Elmue/RFID-Secure-Doorlock/README.md

# RFID-Secure-Doorlock
An electronic doorlock that replaces an unsafe mechanical key with a RFID card using strong encryption.

Before you used:

Key

Now you use:

Mifare

For a detailed description please see:
https://netcult.ch/elmue/RFID-Secure-Doorlock/
