Elmue/RFID-Secure-Doorlock/DataSheets/Mifare Card Detection Procedure.png

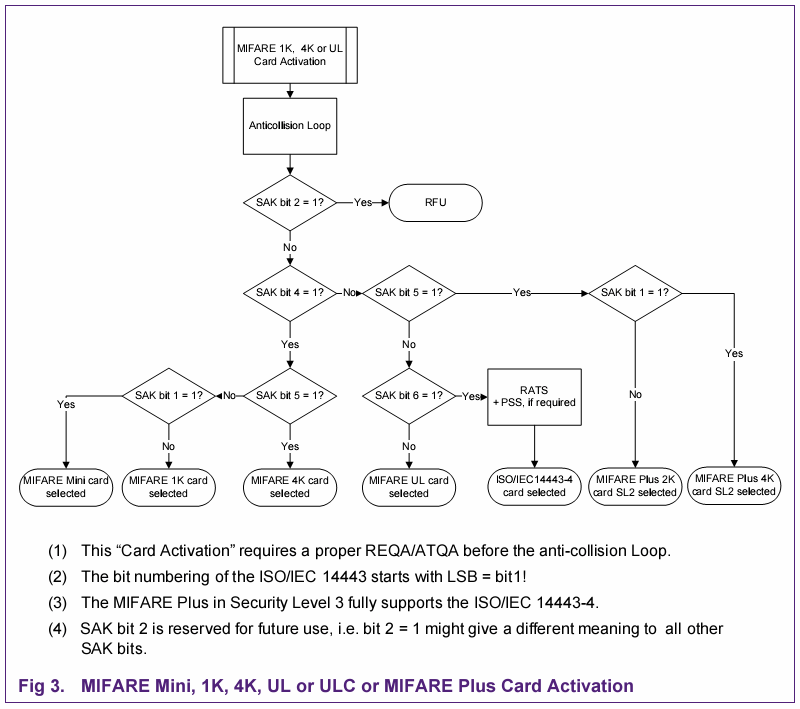
DataSheets/Mifare Card Detection Procedure.png
