Elmue/RFID-Secure-Doorlock/DataSheets/Teensy 3.2.png

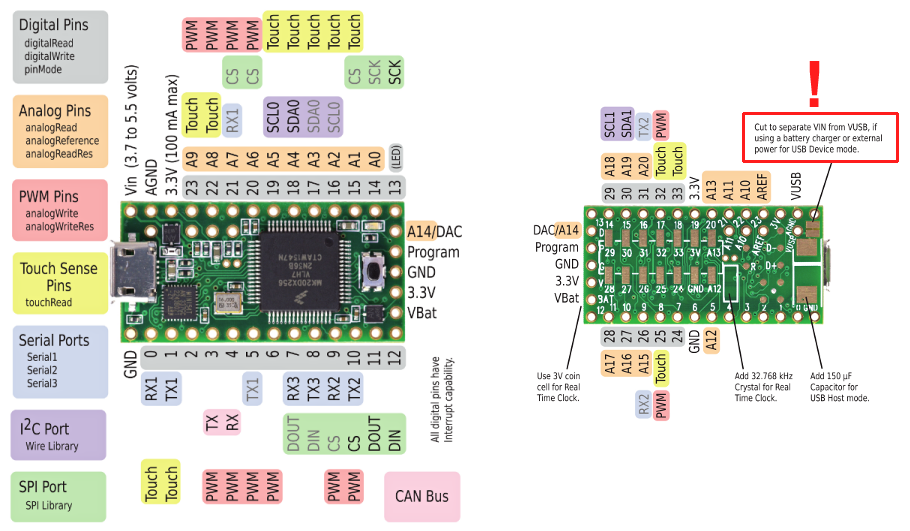
DataSheets/Teensy 3.2.png
