Elmue/RFID-Secure-Doorlock/Diagrams/Board (Pathway and Grid).png

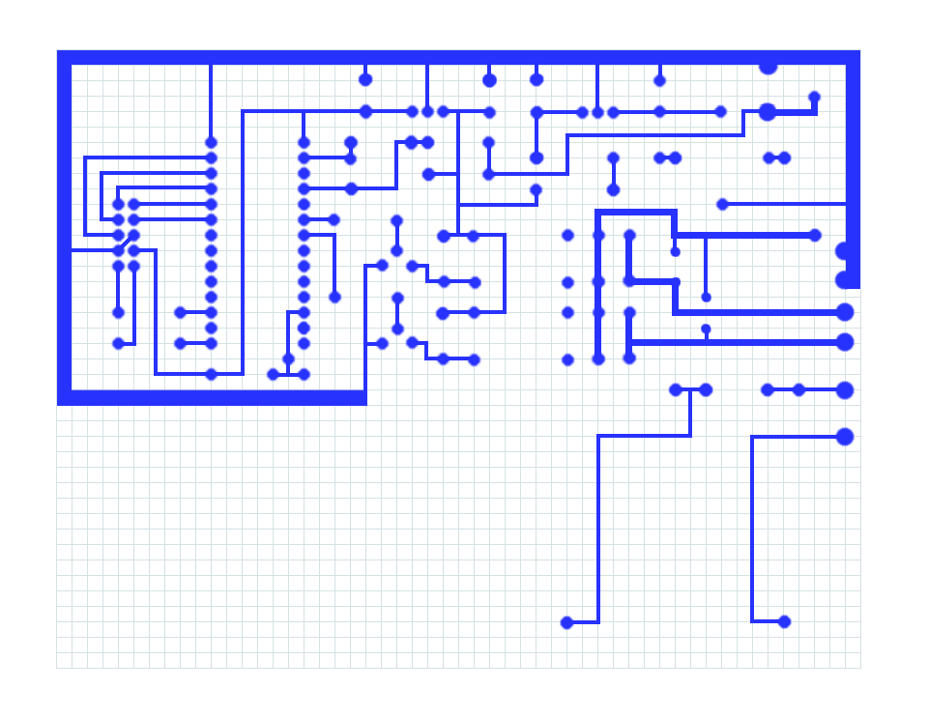
Diagrams/Board (Pathway and Grid).png
