Elmue/RFID-Secure-Doorlock/Diagrams/Board (Pathway only).png

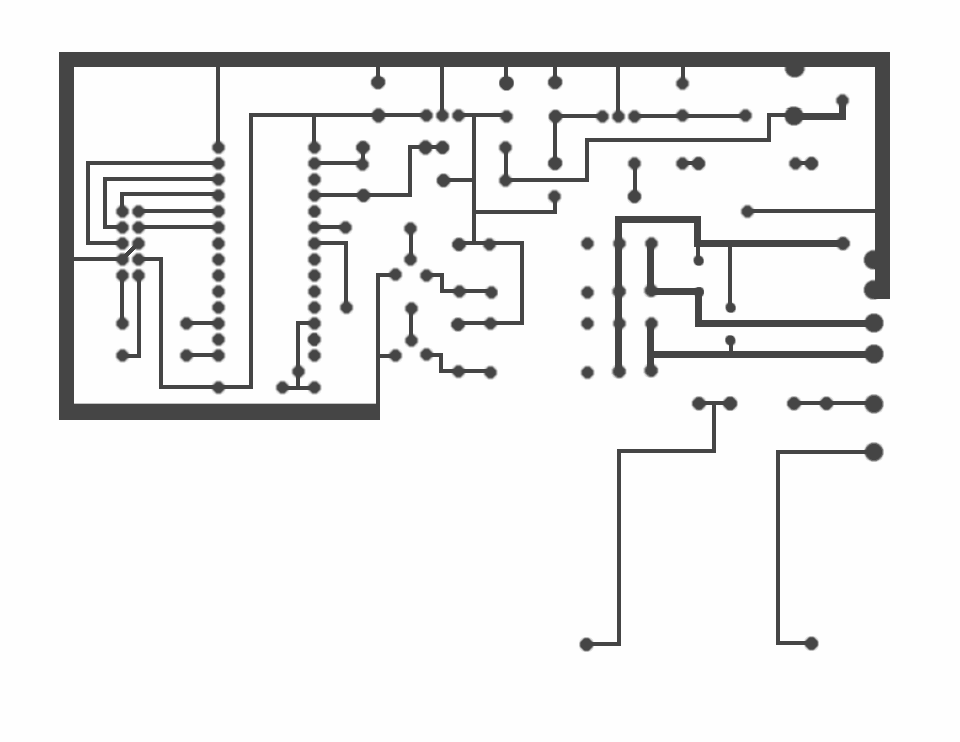
Diagrams/Board (Pathway only).png
