Elmue/RFID-Secure-Doorlock/Diagrams/Board (Parts and Grid).png

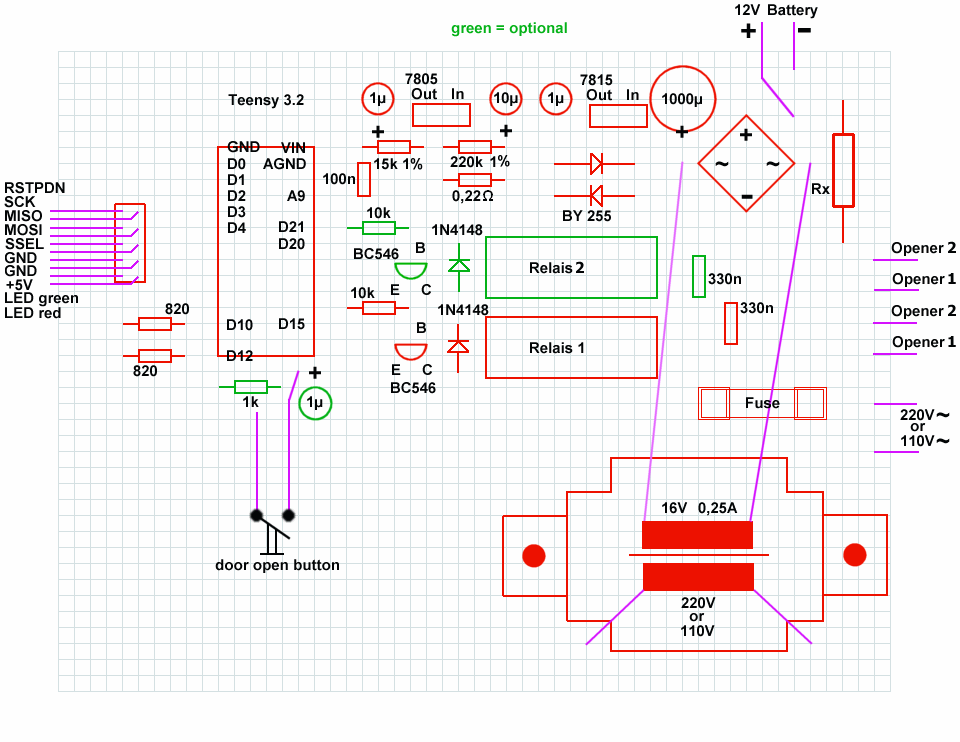
Diagrams/Board (Parts and Grid).png
