Elmue/RFID-Secure-Doorlock/Adafruit Board Eagle Files/Adafruit PN532_Breakout_v1.6.brd

## EAGLE design Adafruit Board Eagle Files/Adafruit PN532_Breakout_v1.6.brd (2025-02-19)

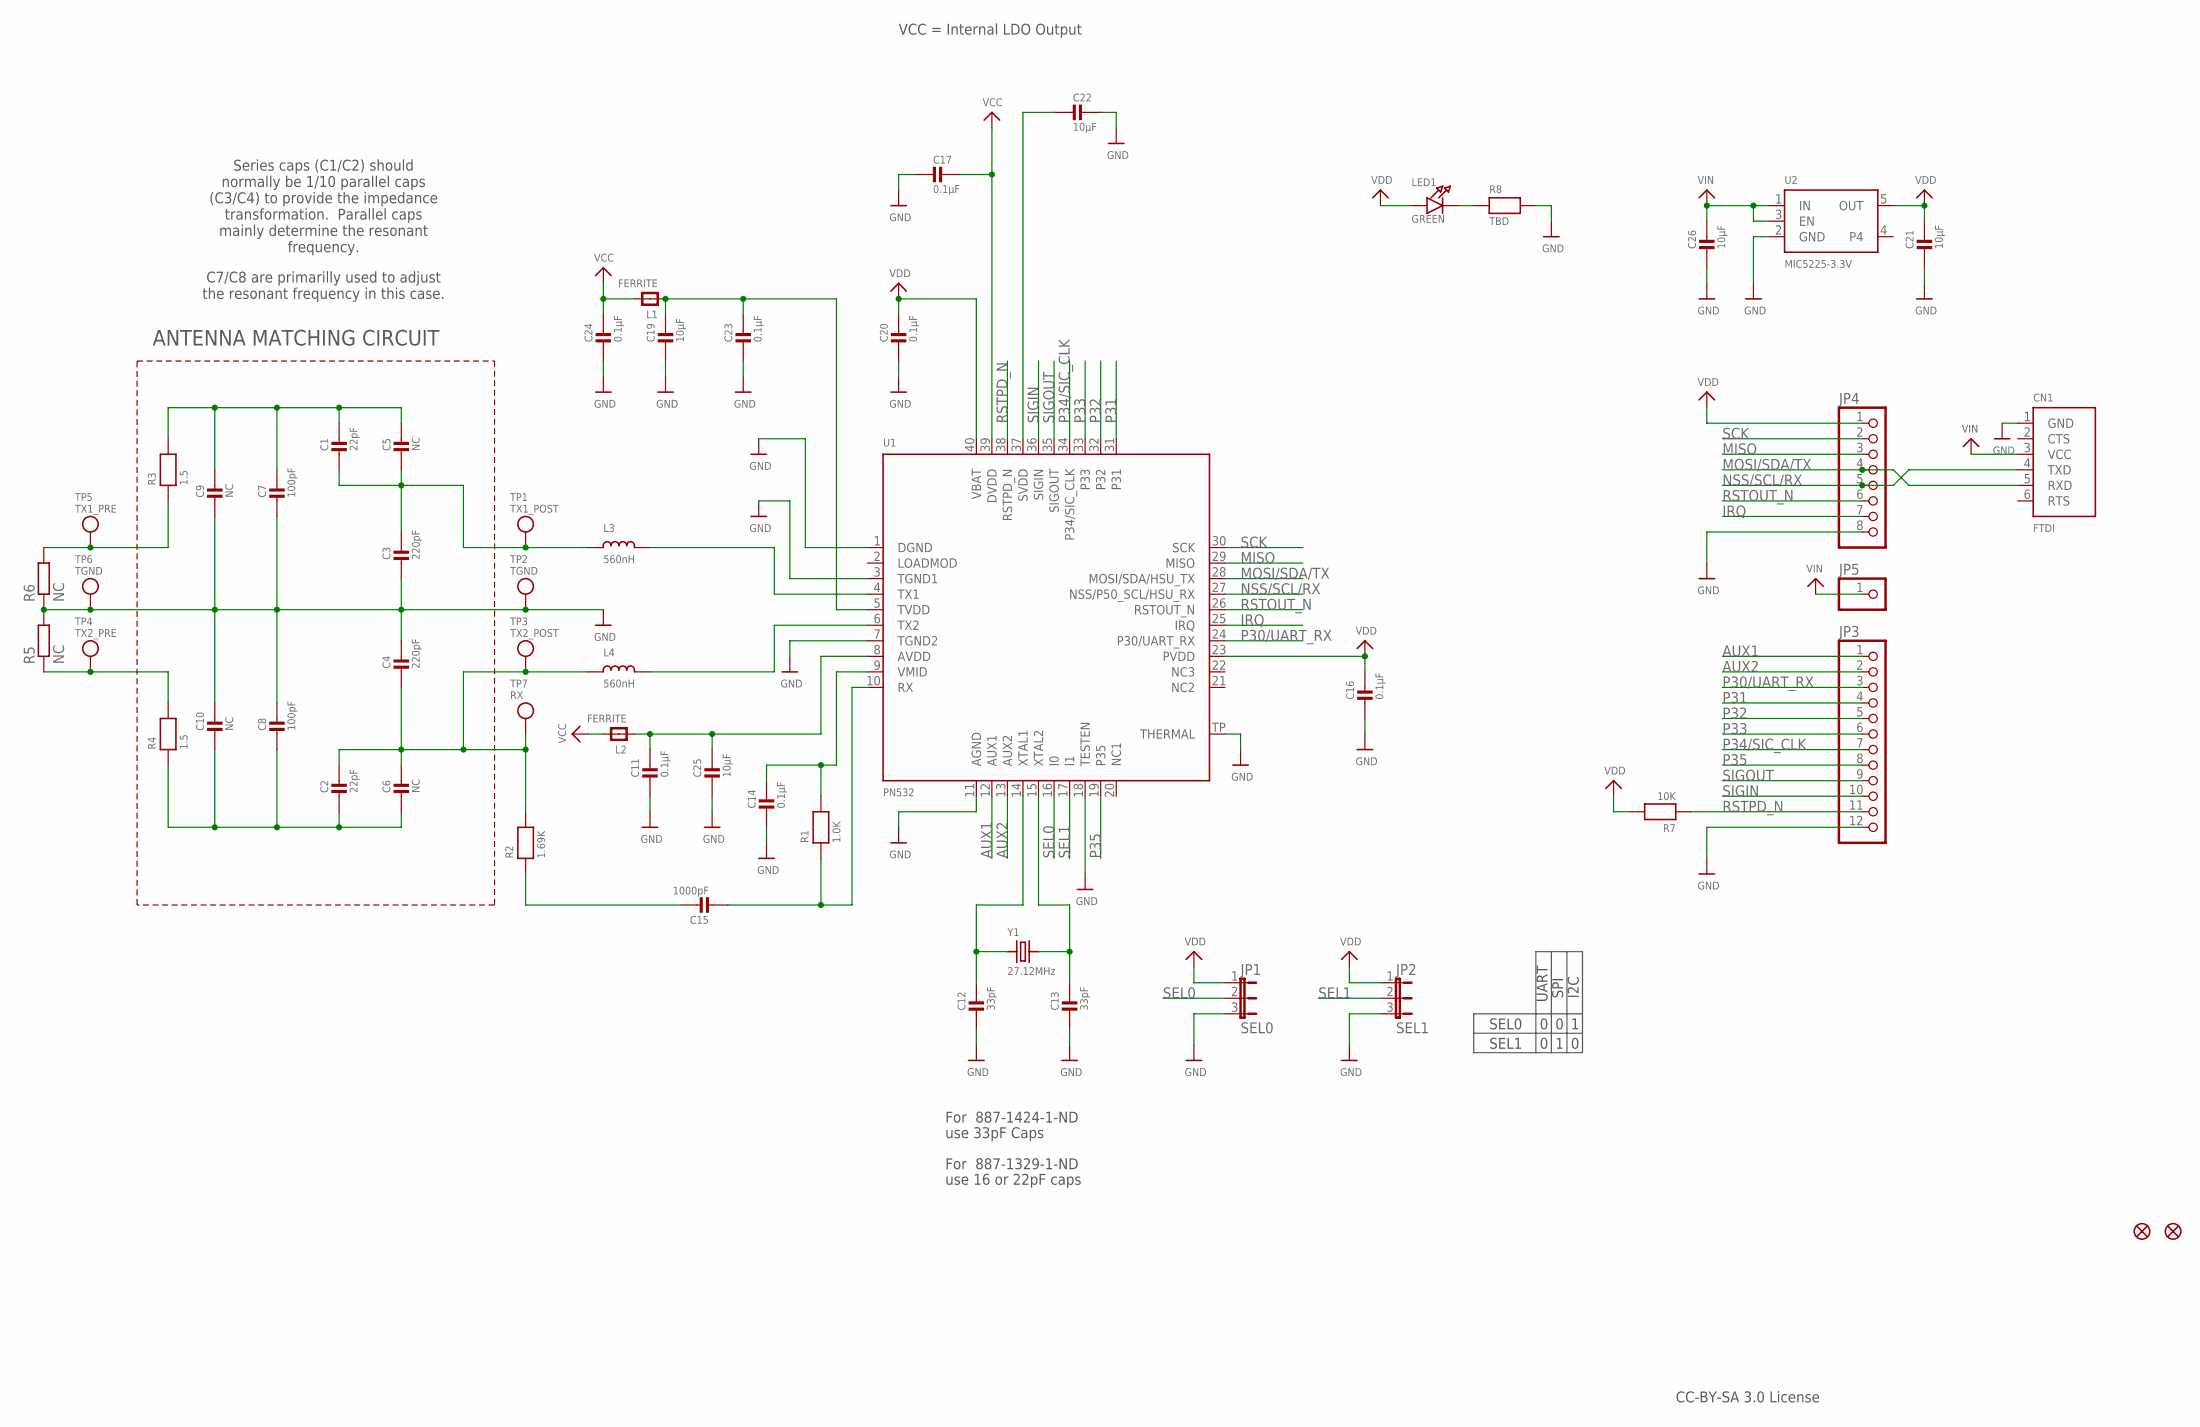
[picture p31: schematic Adafruit PN532_Breakout_v1.6.sch]

Parts:
C1, C2: 22pF; 0805-NO
C3, C4: 220pF; 0805-NO
C5, C6, C9, C10: NC; 0805-NO
C7, C8: 100pF; 0805-NO
C11, C14, C16, C17, C20, C23, C24: 0.1µF; 0805-NO
C12, C13: 33pF; 0805-NO
C15: 1000pF; 0805-NO
C19, C21, C22, C25, C26: 10µF; 0805-NO
CN1: FTDI; 1X06_ROUND
FID1, FID2: FIDUCIAL1X2.5; FIDUCIAL-1X2.5
JP1: SEL0; JUMPER3
JP2: SEL1; JUMPER3
JP3: HEADER-1X12; 1X12_ROUND
JP4: HEADER-1X8ROUND; 1X08_ROUND
JP5: HEADER-1X1ROUND; 1X01_ROUND
L1, L2: FERRITE; 0805
L3, L4: 560nH; 0805
LED1: GREEN; CHIPLED_0805_NOOUTLINE
R1: 1.0K; 0805-NO
R2: 1.69K; 0805-NO
R3, R4: 1.5; 0805-NO
R5, R6: NC; R0201
R7: 10K; 0805-NO
R8: TBD; 0805-NO
TP1: TX1_POST; TESTPOINT_ROUND_1MM
TP2, TP6: TGND; TESTPOINT_ROUND_1MM
TP3: TX2_POST; TESTPOINT_ROUND_1MM
TP4: TX2_PRE; TESTPOINT_ROUND_1MM
TP5: TX1_PRE; TESTPOINT_ROUND_1MM
TP7: RX; TESTPOINT_ROUND_1MM
U1: PN532; HVQFN40-6X6
U2: MIC5225-3.3V; SOT23-5
Y1: 27.12MHz; CRYSTAL_3.2X2.5

Connections:
+5.0V: C26.1, CN1.3 (VCC), JP5.1, U2.1 (IN), U2.3 (EN)
AUX1: JP3.1, U1.12 (AUX1)
AUX2: JP3.2, U1.13 (AUX2)
GND: C3.2, C4.1, C7.2, C8.1, C9.2, C10.1, C11.2, C12.2, C13.2, C14.2, C16.2, C17.2, C19.2, C20.2, C21.2, C22.1, C23.2, C24.2, C25.2, C26.2, CN1.1 (GND), JP1.3, JP2.3, JP3.12, JP4.8, R5.2, R6.1, R8.2, TP2.P$1, TP6.P$1, U1.1 (DGND), U1.3 (TGND1), U1.7 (TGND2), U1.11 (AGND), U1.18 (TESTEN), U1.TP (THERMAL), U2.2 (GND)
IRQ: JP4.7, U1.25 (IRQ)
MISO: JP4.3, U1.29 (MISO)
MOSI/SDA/TX: CN1.5 (RXD), JP4.4, U1.28 (MOSI/SDA/HSU_TX)
unnamed: L3.2, U1.4 (TX1)
unnamed: L4.2, U1.6 (TX2)
unnamed: C1.2, C3.1, C5.2, L3.1, TP1.P$1
unnamed: R3.1, R6.2, TP5.P$1
unnamed: R4.2, R5.1, TP4.P$1
unnamed: LED1.C, R8.1
unnamed: C12.1, U1.14 (XTAL1), Y1.1
unnamed: C13.1, U1.15 (XTAL2), Y1.2
unnamed: C15.1, R2.1
unnamed: C14.1, R1.2, U1.9 (VMID)
unnamed: C15.2, R1.1, U1.10 (RX)
unnamed: C2.1, C4.2, C6.1, L4.1, R2.2, TP3.P$1, TP7.P$1
unnamed: C11.1, C25.1, L2.1, U1.8 (AVDD)
unnamed: C19.1, C23.1, L1.1, U1.5 (TVDD)
unnamed: C22.2, U1.37 (SVDD)
NSS/SCL/RX: CN1.4 (TXD), JP4.5, U1.27 (NSS/P50_SCL/HSU_RX)
P30/UART_RX: JP3.3, U1.24 (P30/UART_RX)
P31: JP3.4, U1.31
P32: JP3.5, U1.32
P33: JP3.6, U1.33
P34/SIC_CLK: JP3.7, U1.34 (P34/SIC_CLK)
P35: JP3.8, U1.19 (P35)
RSTOUT_N: JP4.6, U1.26 (RSTOUT_N)
RSTPD_N: JP3.11, R7.1, U1.38 (RSTPD_N)
SCK: JP4.2, U1.30 (SCK)
SEL0: JP1.2, U1.16 (I0)
SEL1: JP2.2, U1.17 (I1)
SIGIN: JP3.10, U1.36 (SIGIN)
SIGOUT: JP3.9, U1.35 (SIGOUT)
TX1_ANTENNA: C1.1, C5.1, C7.1, C9.1, R3.2
TX2_ANTENNA: C2.2, C6.2, C8.2, C10.2, R4.1
VCC: C17.1, C24.1, L1.2, L2.2, U1.39 (DVDD)
VDD: C16.1, C20.1, C21.1, JP1.1, JP2.1, JP4.1, LED1.A, R7.2, U1.23 (PVDD), U1.40 (VBAT), U2.5 (OUT)

Notes on the sheet:
ANTENNA MATCHING CIRCUIT
SEL0
SEL1
UART
SPI
I2C
CC-BY-SA 3.0 License
For 887-1329-1-ND
use 16 or 22pF caps
For 887-1424-1-ND
use 33pF Caps
VCC = Internal LDO Output
Series caps (C1/C2) should normally be 1/10 parallel caps (C3/C4) to provide the impedance transformation. Parallel caps mainly determine the resonant frequency.
C7/C8 are primarilly used to adjust the resonant frequency in this case.

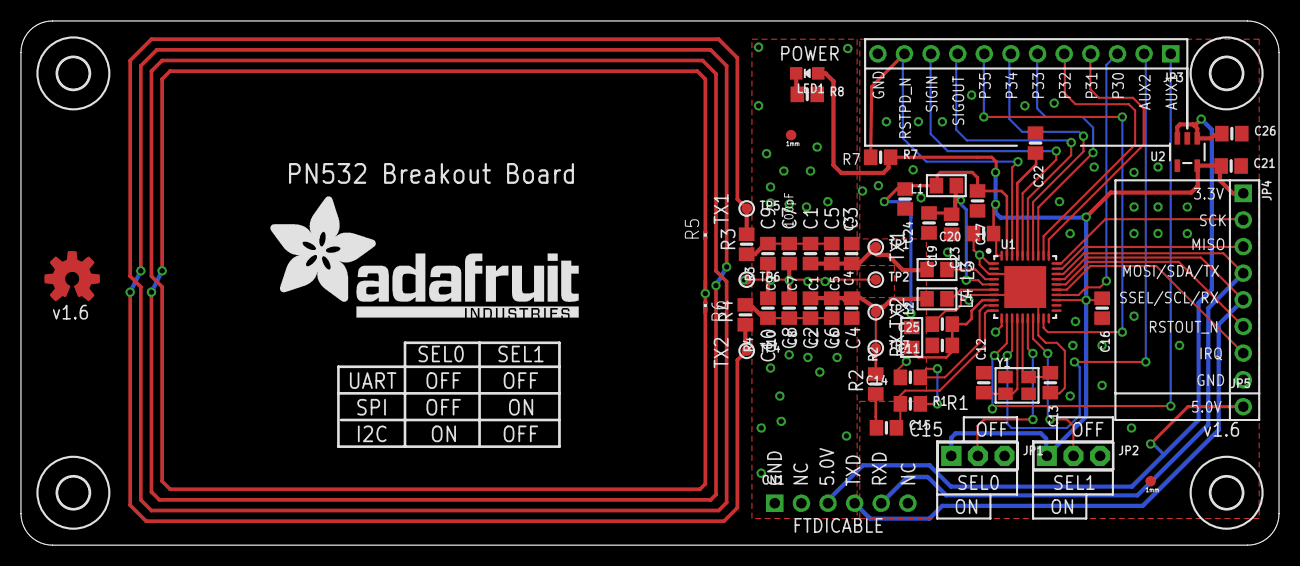
[picture p32: board Adafruit PN532_Breakout_v1.6.brd from above]

Board: 2 copper layers, 120.0 x 50.0 mm, 62 parts (0 on the bottom side), 40 nets.

Other parts of the board:
U$1: ADAFRUIT_TEXT_30MM
U$6, U$36, U$37, U$38: MOUNTINGHOLE_3.0
U$50: OSHWLOGO_TOP_0.2
